anshkumar/pocket-link/revA/docs/DRC_report.txt

** Drc report for kicad/pocket-link.kicad_pcb **
** Created on 2026-10-06 11:25:38 **

** Found 0 DRC violations **

** Found 0 unconnected pads **

** Found 0 Footprint errors **

** End of Report **
