anshkumar/pocket-link/revA/fab/BOM_full.csv

Qty | Designators | Value | Description | Manufacturer | MPN | LCSC | Footprint | Assemble | Est. unit USD | Est. line USD
1 | J1 | USB-C plug | USB-C plug, board-edge straddle mount (0.8 mm PCB). Alt: SHOU HAN TYPE-C 24P GTJB | Molex | 105444-0001 | C134082 | USB_C_Plug_Molex_105444 | hand-solder after SMT | 0.920 | 0.92
1 | R1 | 5.1k | CC Rd (USB device) | UNI-ROYAL | 0402WGF5101TCE | C25905 | R_0402_1005Metric | yes | 0.001 | 0.00
1 | U4 | USBLC6-2SC6 | USB ESD array | ST | USBLC6-2SC6 | C7519 | SOT-23-6 | yes | 0.080 | 0.08
2 | R2 R3 | 27R | USB series | UNI-ROYAL | 0402WGF270JTCE | C25100 | R_0402_1005Metric | yes | 0.001 | 0.00
1 | U3 | AP2112K-3.3 | 3.3V 600mA LDO | Diodes Inc | AP2112K-3.3TRG1 | C51118 | SOT-23-5 | yes | 0.060 | 0.06
3 | C1 C20 C21 | 1uF |  | Samsung | CL05A105KA5NQNC | C52923 | C_0402_1005Metric | yes | 0.003 | 0.01
1 | C2 | 10uF |  | Samsung | CL10A106KP8NNNC | C19702 | C_0603_1608Metric | yes | 0.010 | 0.01
1 | U1 | RP2040 | Dual M0+ MCU, USB 1.1 device (UAC + vendor/CDC via TinyUSB) | Raspberry Pi | RP2040 | C2040 | QFN-56-1EP_7x7mm_P0.4mm_EP3.2x3.2mm_Vias0.3 | yes | 0.800 | 0.80
12 | C10 C11 C12 C13 C14 C15 C16 C17 C18 C22 C23 C26 | 100nF |  | Samsung | CL05B104KO5NNNC | C1525 | C_0402_1005Metric | yes | 0.002 | 0.02
1 | Y1 | 12MHz | 12 MHz 20 pF 3225 | YXC | X322512MSB4SI | C9002 | Crystal_SMD_3225-4Pin_3.2x2.5mm | yes | 0.080 | 0.08
3 | R4 R5 R6 | 1k |  | UNI-ROYAL | 0402WGF1001TCE | C11702 | R_0402_1005Metric | yes | 0.001 | 0.00
2 | C24 C25 | 33pF | crystal load | FH | 0402CG330J500NT | C1562 | C_0402_1005Metric | yes | 0.002 | 0.00
1 | U2 | W25Q16JVSNIQ | 16 Mbit QSPI flash (firmware) | Winbond | W25Q16JVSNIQ | C2456211 | SOIC-8_3.9x4.9mm_P1.27mm | yes | 0.200 | 0.20
1 | D1 | GREEN | status | Everlight | 19-217/GHC-YR1S2/3T | C72043 | LED_0603_1608Metric | yes | 0.010 | 0.01
 |  |  | Parts total per adapter |  |  |  |  |  |  | 2.20
