anshkumar/pocket-link/revA/fab/Pocket-Link-revA.step

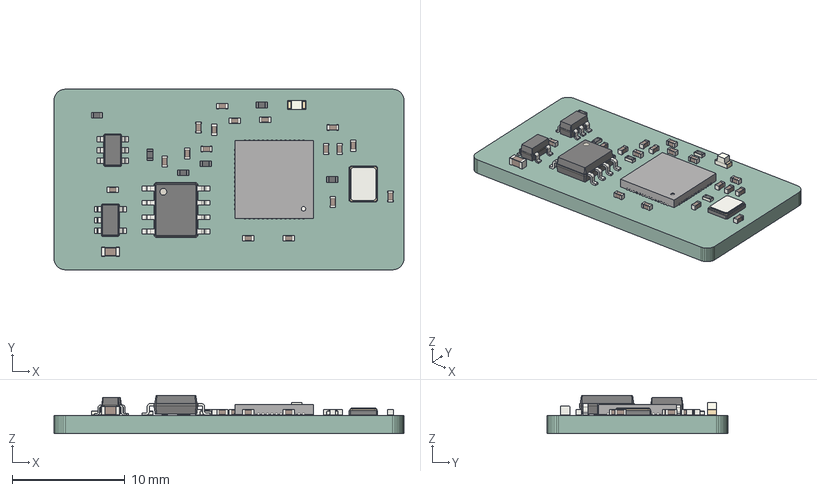
[picture p1: CAD file, 2026-10-20, an earlier design]
revA/fab/Pocket-Link-revA.step
31.0 x 16.0 x 3.40 mm
SOIC_8_39x49mm_P127mm
SOT_23_6
R_0402_1005Metric x 6
C_0402_1005Metric x 17
QFN_56_1EP_7x7mm_P04mm_EP32x32mm
LED_0603_1608Metric
Crystal_SMD_3225-4Pin_3.2x2.5mm
SOT_23_5
C_0603_1608Metric
pocket-link PCB
