anshkumar/pocket-link/revA/docs/verification.txt

schematic <-> design: MATCH (21 nets, 34 symbols)
PCB <-> design: MATCH 34 footprints
** Found 0 DRC violations **
** Found 0 unconnected pads **
** Found 0 Footprint errors **
