anshkumar/pocket-link/revA/kicad/pocket-link.kicad_pcb

## KiCad design revA/kicad/pocket-link.kicad_pcb (2026-10-20, an earlier design)

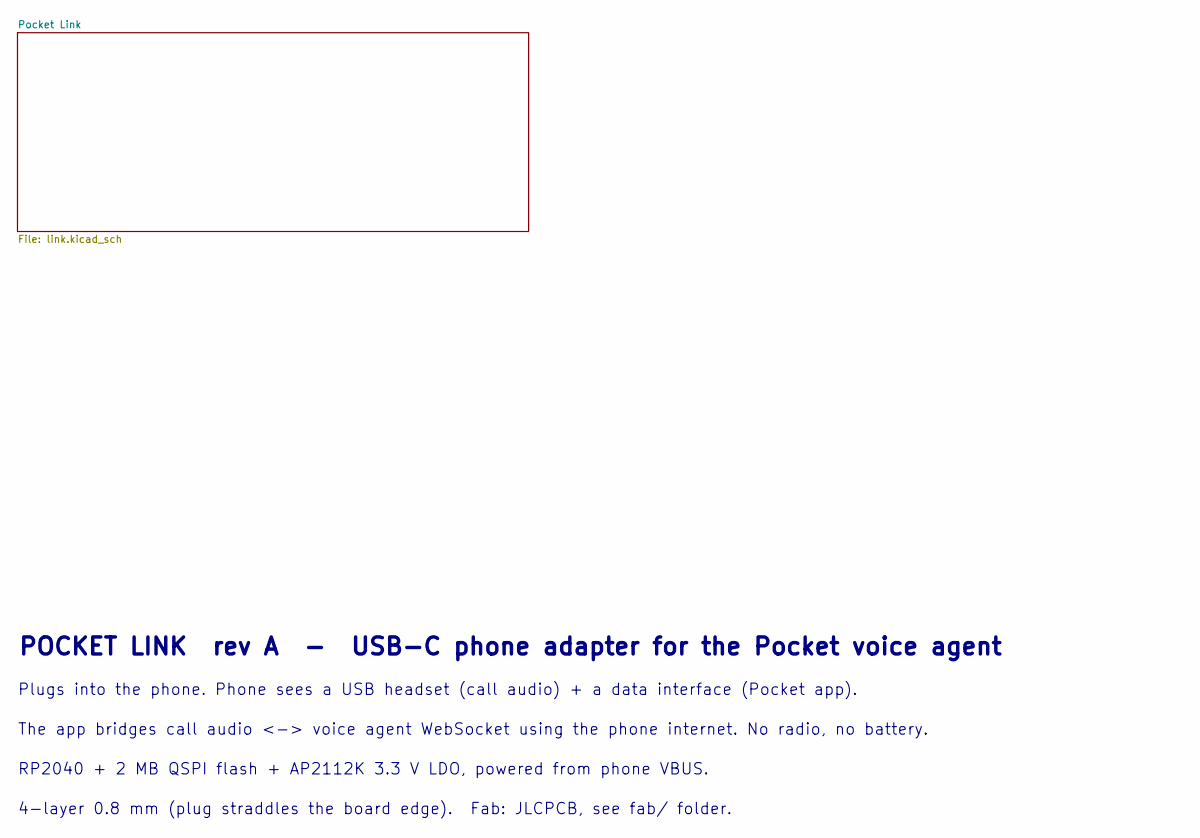
[picture p9: schematic pocket-link.kicad_sch, Pocket Hub-8]

Notes on the sheet:
POCKET LINK rev A - USB-C phone adapter for the Pocket voice agent
Plugs into the phone. Phone sees a USB headset (call audio) + a data interface (Pocket app).
The app bridges call audio <-> voice agent WebSocket using the phone internet. No radio, no battery.
RP2040 + 2 MB QSPI flash + AP2112K 3.3 V LDO, powered from phone VBUS.
4-layer 0.8 mm (plug straddles the board edge). Fab: JLCPCB, see fab/ folder.

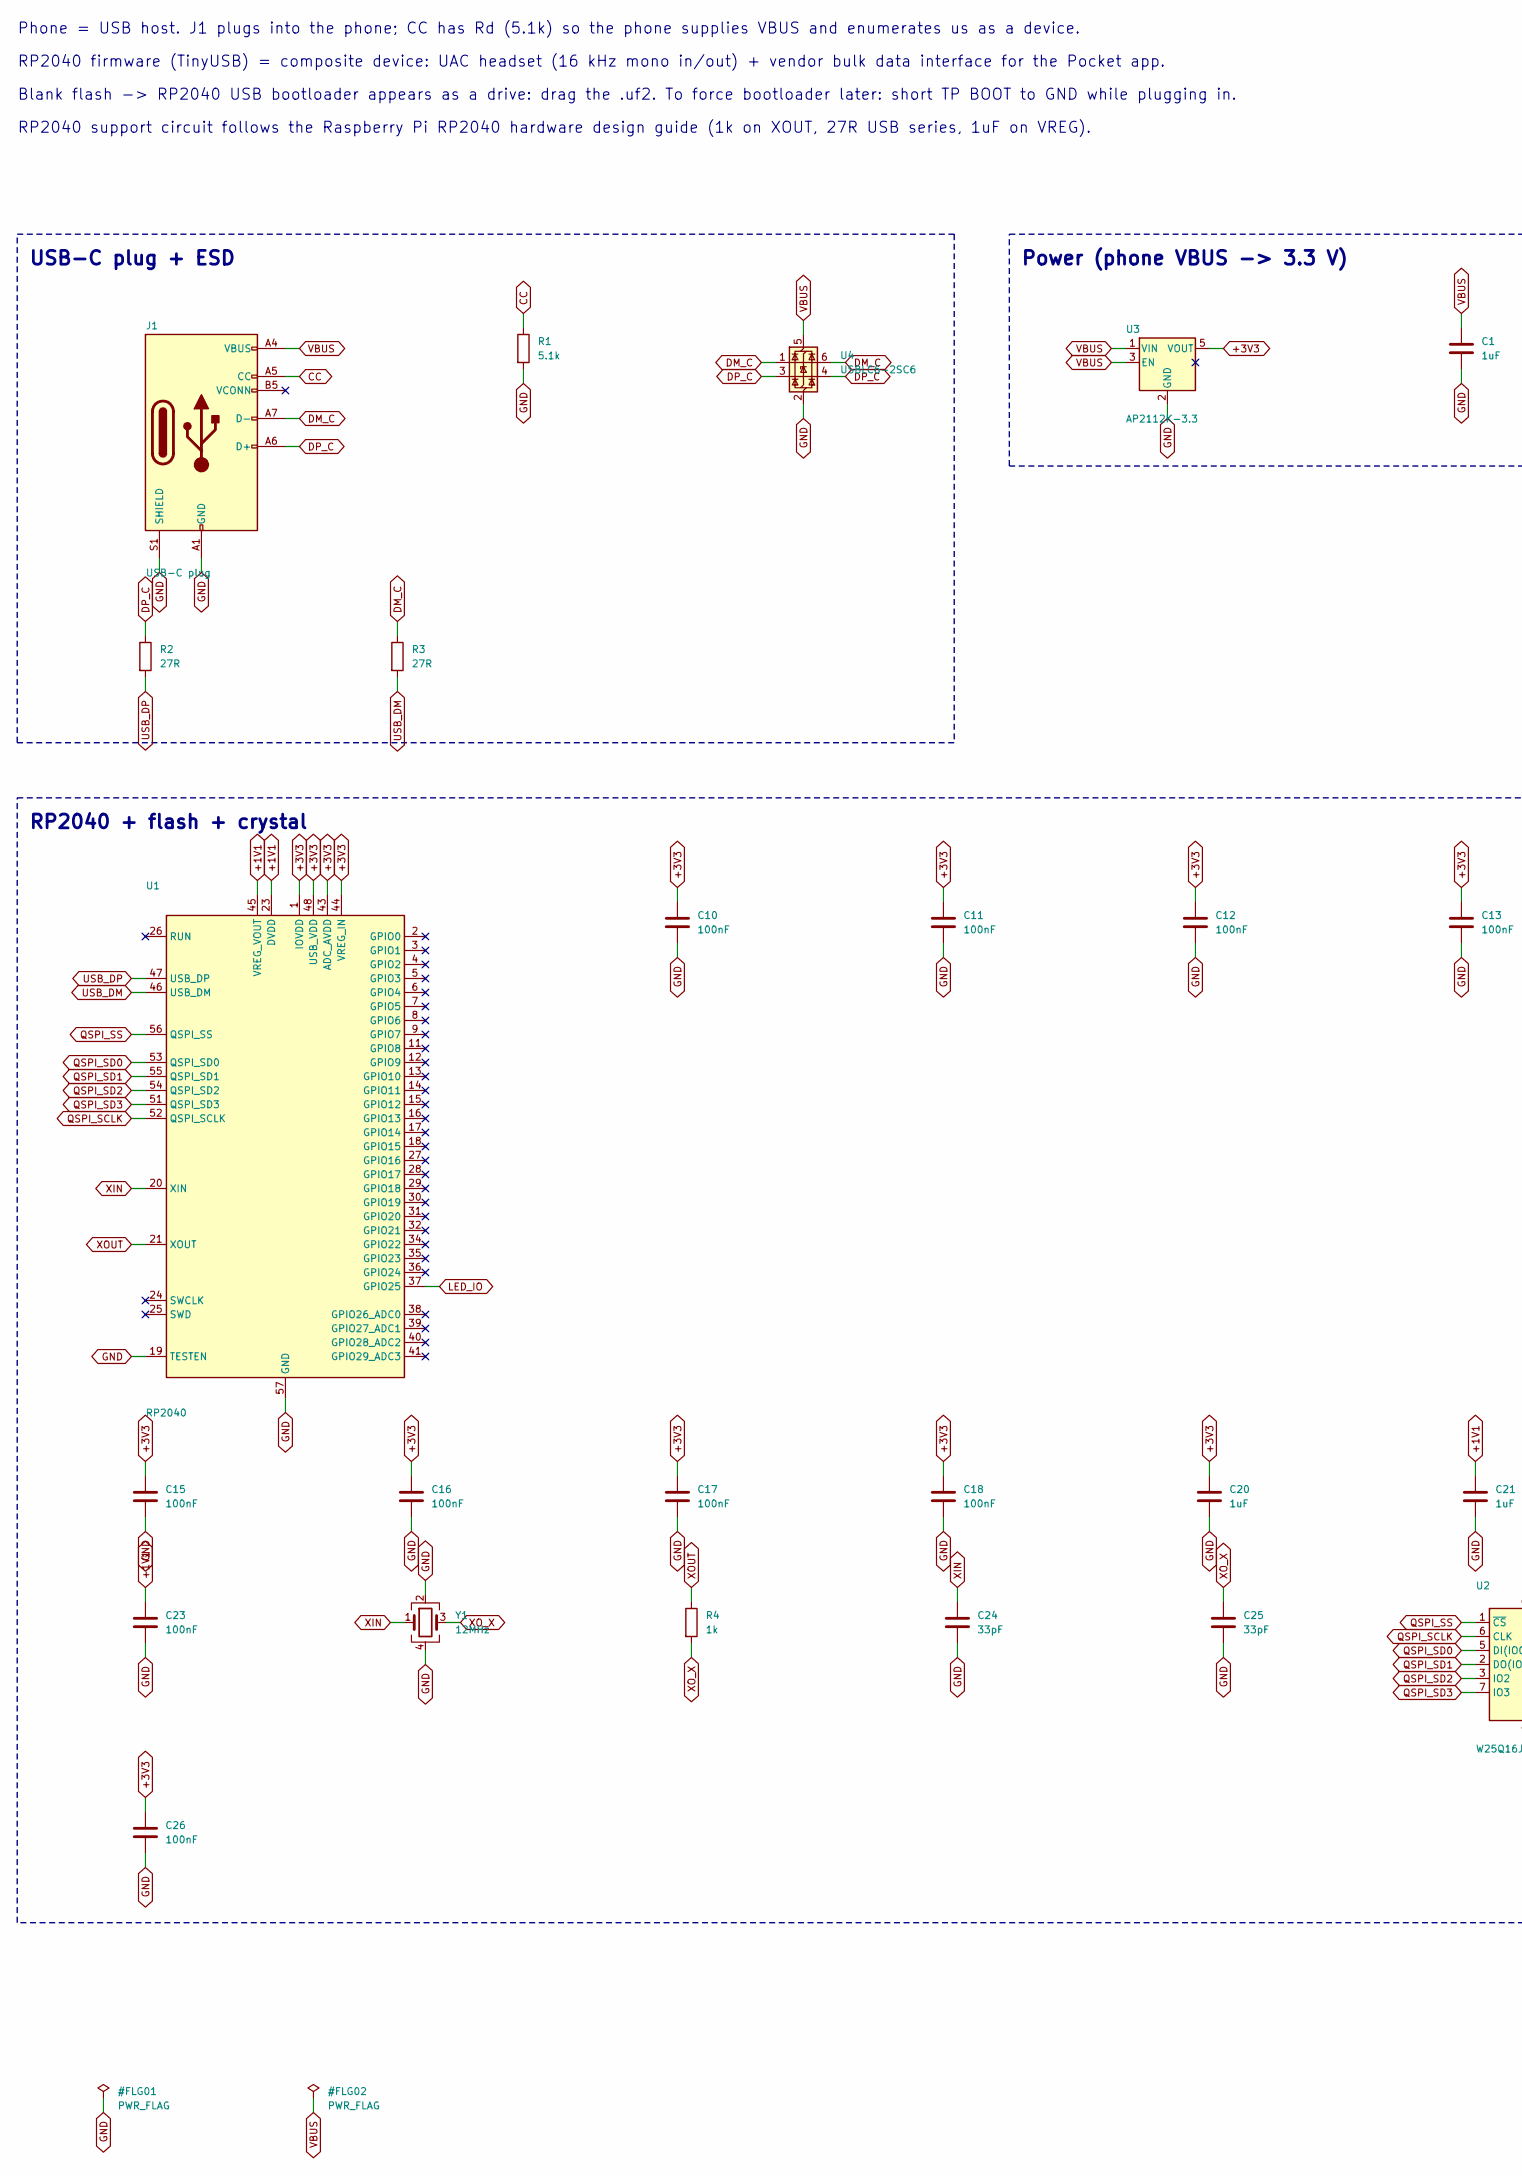
[picture p10: schematic link.kicad_sch, Pocket Link - Pocket Link - USB-C phone adapter, part in row 1, column 1]

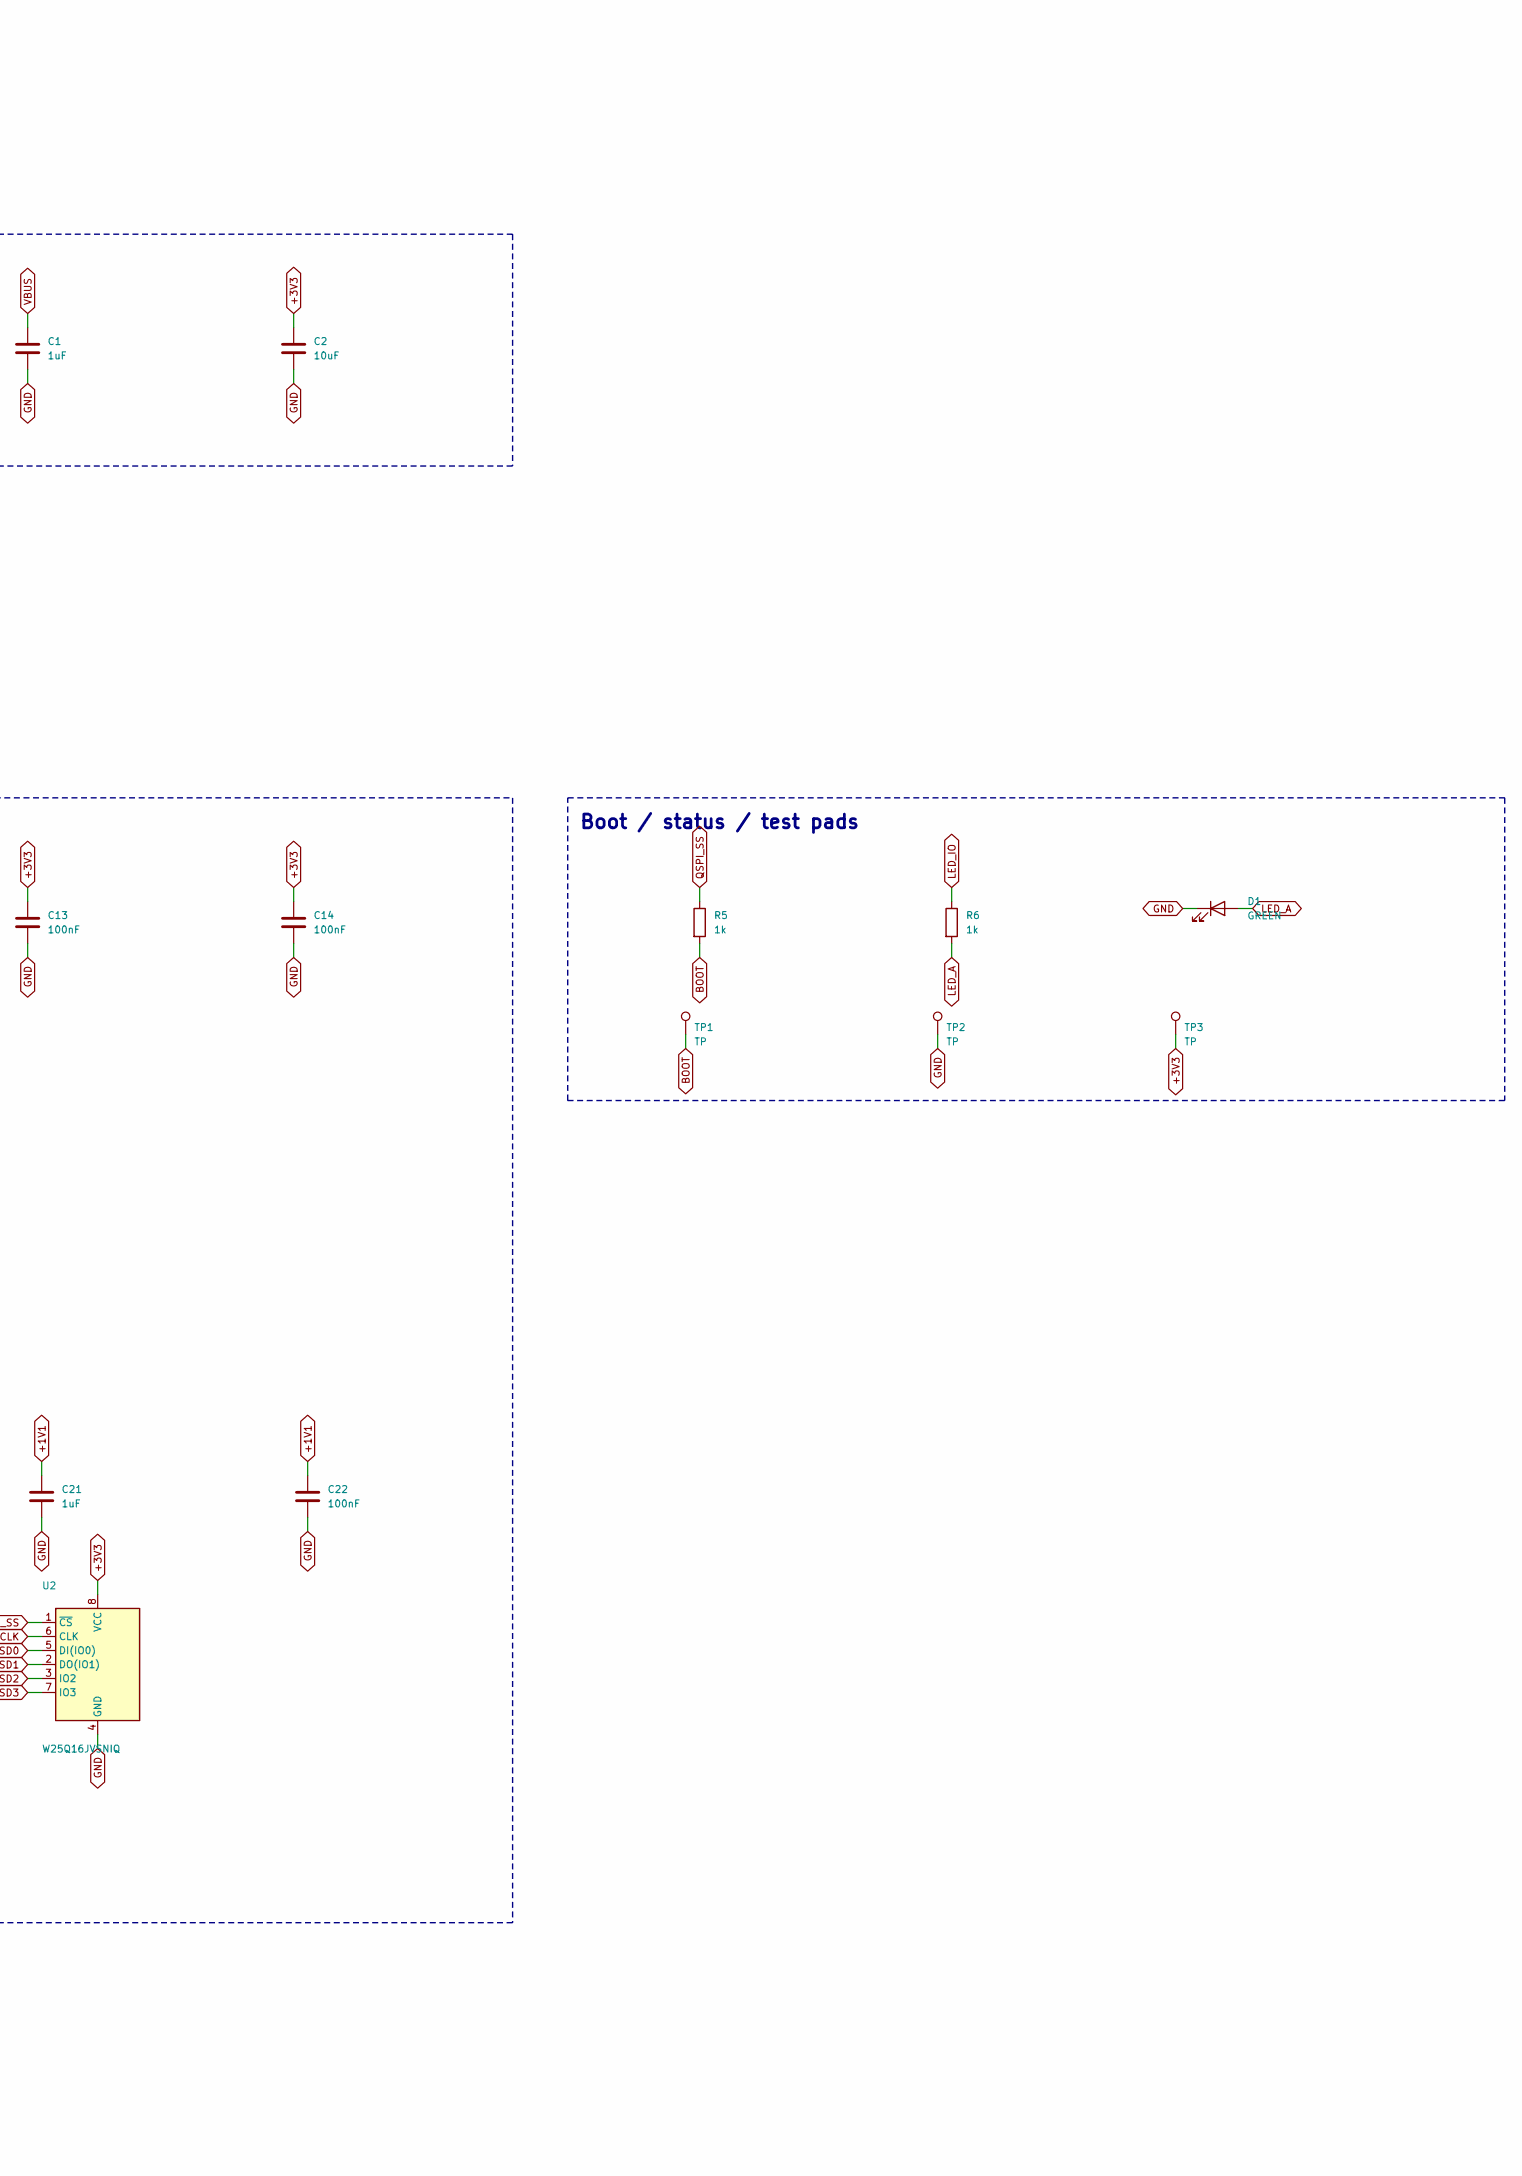
[picture p11: schematic link.kicad_sch, Pocket Link - Pocket Link - USB-C phone adapter, part in row 1, column 2]

Parts:
C1, C20, C21: 1uF; C_0402_1005Metric; MPN CL05A105KA5NQNC; LCSC C52923
C2: 10uF; C_0603_1608Metric; MPN CL10A106KP8NNNC; LCSC C19702
C10, C11, C12, C13, C14, C15, C16, C17, C18, C22, C23, C26: 100nF; C_0402_1005Metric; MPN CL05B104KO5NNNC; LCSC C1525
C24, C25: 33pF; C_0402_1005Metric; MPN 0402CG330J500NT; LCSC C1562
D1: GREEN; LED_0603_1608Metric; MPN 19-217/GHC-YR1S2/3T; LCSC C72043
J1: USB-C plug; USB_C_Plug_Molex_105444; MPN 105444-0001; LCSC C134082
R1: 5.1k; R_0402_1005Metric; MPN 0402WGF5101TCE; LCSC C25905
R2, R3: 27R; R_0402_1005Metric; MPN 0402WGF270JTCE; LCSC C25100
R4, R5, R6: 1k; R_0402_1005Metric; MPN 0402WGF1001TCE; LCSC C11702
TP1, TP2, TP3: TP; TestPoint_Pad_D1.0mm
U1: RP2040; QFN-56-1EP_7x7mm_P0.4mm_EP3.2x3.2mm_Vias0.3; MPN RP2040; LCSC C2040
U2: W25Q16JVSNIQ; SOIC-8_3.9x4.9mm_P1.27mm; MPN W25Q16JVSNIQ; LCSC C2456211
U3: AP2112K-3.3; SOT-23-5; MPN AP2112K-3.3TRG1; LCSC C51118
U4: USBLC6-2SC6; SOT-23-6; MPN USBLC6-2SC6; LCSC C7519
Y1: 12MHz; Crystal_SMD_3225-4Pin_3.2x2.5mm; MPN X322512MSB4SI; LCSC C9002

Connections:
+1V1: C21.1, C22.1, C23.1, U1.23 (DVDD), U1.45 (VREG_VOUT), U1.50 (DVDD)
+3V3: C2.1, C10.1, C11.1, C12.1, C13.1, C14.1, C15.1, C16.1, C17.1, C18.1, C20.1, C26.1, TP3.1, U1.1 (IOVDD), U1.10 (IOVDD), U1.22 (IOVDD), U1.33 (IOVDD), U1.42 (IOVDD), U1.43 (ADC_AVDD), U1.44 (VREG_IN), U1.48 (USB_VDD), U1.49 (IOVDD), U2.8 (VCC), U3.5 (VOUT)
BOOT: R5.2, TP1.1
CC: J1.A5 (CC), R1.1
DM_C: J1.A7 (D-), R3.1, U4.1 (I/O1), U4.6 (I/O1)
DP_C: J1.A6 (D+), R2.1, U4.3 (I/O2), U4.4 (I/O2)
GND: C1.2, C2.2, C10.2, C11.2, C12.2, C13.2, C14.2, C15.2, C16.2, C17.2, C18.2, C20.2, C21.2, C22.2, C23.2, C24.2, C25.2, C26.2, D1.1 (K), J1.A1 (GND), J1.A12 (GND), J1.B1 (GND), J1.B12 (GND), J1.S1 (SHIELD), R1.2, TP2.1, U1.19 (TESTEN), U1.57 (GND), U2.4 (GND), U3.2 (GND), U4.2 (GND), Y1.2, Y1.4
LED_A: D1.2 (A), R6.2
LED_IO: R6.1, U1.37 (GPIO25)
QSPI_SCLK: U1.52 (QSPI_SCLK), U2.6 (CLK)
QSPI_SD0: U1.53 (QSPI_SD0), U2.5 (DI(IO0))
QSPI_SD1: U1.55 (QSPI_SD1), U2.2 (DO(IO1))
QSPI_SD2: U1.54 (QSPI_SD2), U2.3 (IO2)
QSPI_SD3: U1.51 (QSPI_SD3), U2.7 (IO3)
QSPI_SS: R5.1, U1.56 (QSPI_SS), U2.1 (~CS)
USB_DM: R3.2, U1.46 (USB_DM)
USB_DP: R2.2, U1.47 (USB_DP)
VBUS: C1.1, J1.A4 (VBUS), J1.A9 (VBUS), J1.B4 (VBUS), J1.B9 (VBUS), U3.1 (VIN), U3.3 (EN), U4.5 (VBUS)
XIN: C24.1, U1.20 (XIN), Y1.1
XOUT: R4.1, U1.21 (XOUT)
XO_X: C25.1, R4.2, Y1.3

Notes on the sheet:
Phone = USB host. J1 plugs into the phone; CC has Rd (5.1k) so the phone supplies VBUS and enumerates us as a device.
RP2040 firmware (TinyUSB) = composite device: UAC headset (16 kHz mono in/out) + vendor bulk data interface for the Pocket app.
Blank flash -> RP2040 USB bootloader appears as a drive: drag the .uf2. To force bootloader later: short TP BOOT to GND while plugging in.
RP2040 support circuit follows the Raspberry Pi RP2040 hardware design guide (1k on XOUT, 27R USB series, 1uF on VREG).
USB-C plug + ESD
Power (phone VBUS -> 3.3 V)
RP2040 + flash + crystal
Boot / status / test pads

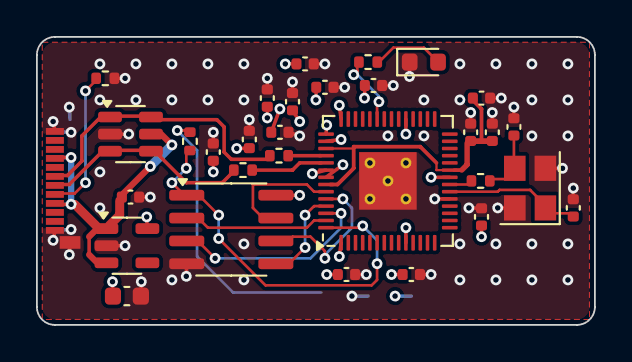
[picture p12: board pocket-link.kicad_pcb from above]

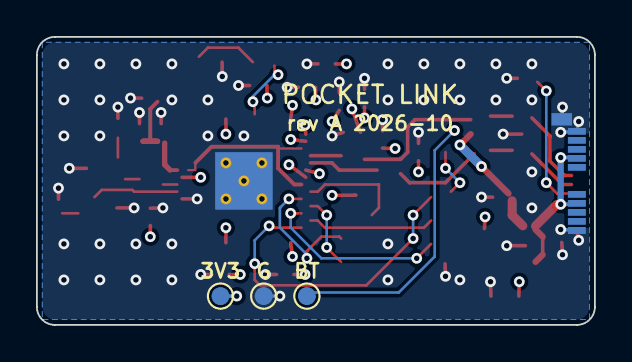
[picture p13: board pocket-link.kicad_pcb from below]

Board: 4 copper layers, 31.0 x 16.0 mm, 34 parts (3 on the bottom side), 21 nets.
