anshkumar/pocket-link/firmware/pocket-link-fw/build.rs

use std::{env, fs, path::PathBuf};
fn main() {
    let out = PathBuf::from(env::var_os("OUT_DIR").unwrap());
    fs::copy("memory.x", out.join("memory.x")).unwrap();
    println!("cargo:rustc-link-search={}", out.display());
    println!("cargo:rerun-if-changed=memory.x");
    // linker script from cortex-m-rt (memory.x is included by it)
    println!("cargo:rustc-link-arg-bins=--nmagic");
    println!("cargo:rustc-link-arg-bins=-Tlink.x");
}
