anshkumar/pocket-link/(commit log)

2026-10-20 Pocket Link goes open: the public hardware tree, and the site says so
    hardware/pocket-link/ holds rev A (KiCad, Gerbers, BOM, CPL, STEP, the
    design.py generator), the RP2040 firmware with its protocol and test tools,
    the rev B plan, a compatibility list, a contributing note and a draft
    pid.codes request. Hardware under CERN-OHL-P-2.0, firmware and tools under
    Apache-2.0; build artefacts and the test app's debug keystore left out.
    /pocket-link and the docs explain what is open and why.
    [BOM_JLCPCB.csv, BOM_PCBPower.csv, BOM_full.csv, Pocket-Link-revA.step, link.kicad_sch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]
2026-10-20 Pocket Link: the public repository is up; the site, docs and PID request point at it
2026-10-20 Pocket Link: pick PID 0xC417 for the pid.codes request
2026-10-20 Pocket Link: pid.codes request submitted (PR #1326)
2026-10-20 Pocket Link 0.2: the adapter is also a touch screen and keyboard for the phone
    The firmware adds a HID interface (touch screen, keyboard, consumer control). The
    Pocket app sends finished reports over the data channel (packet 0x04) and the phone
    takes them as touches and keys on its own display, so a bot can drive other apps with
    nothing but the adapter: no accessibility service, no root.
    The touch report carries Contact ID and Contact Count so the kernel's hid-multitouch
    driver binds and marks the device a direct touch screen; without them Android makes
    it a pointer. LinkInput.kt sequences taps, long presses, swipes, ASCII typing and
    clipboard paste for the rest; the Link service takes benc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
    [hid.rs, link_input_bench.py, main.rs]
2026-10-20 Release v0.11.0: Pocket Link is the bot's hands on the phone
    The site and docs say what firmware 0.2 does (a touch screen and keyboard the app
    drives, proven on the Motorola edge 60, the bot side in testing and for your own
    accounts), the features page has the row, llms.txt carries the line, and the public
    README shows the fifth interface. The 0.11.0 APK with the Link input driver is on
    pocketide.com/pocket.apk.
2026-10-20 Eyes and hands on the phone: bots see the screen and work apps through Pocket Link
    Two phone actions. `screenshot` mirrors the display through Android's screen-capture
    consent (a foreground service holding the projection, asked for on the Phone control
    card) and returns a 0.45x JPEG with red 100-px rulers on its edges; `screen_input`
    sends a tap, hold, swipe, text or key through the adapter's HID interface and returns
    the screen 700 ms later. The runner's phone tool hands the pictures to the model as a
    user turn, Agent mode gates the first input of a run, Ask mode allows looking only.
    Proven end to end on the Motorola edge 60 with Gemini 2.5 Flash: open Settings, tap
    the search bar (the rul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
